sparkfun/SparkFun_Qwiic_WAV_Trigger_Pro/(notices)

Notices in the files:
parts and their libraries:
https://creativecommons.org/licenses/by-sa/4.0
Released under the Creative Commons Attribution Share-Alike 4.0 License
